Sharif-University-ESRLab/project-97110036-98105813/README.md

Project: Calculating the Power of SmartButton 

Project No. 2

Group No. 4

Members:
- Mohammad Ali Pashanj 97110036
- Mohammad Bagher Soltani 98105813

Summer 2022
