Sharif-University-ESRLab/project-97110036-98105813/Datasheet/Packaging/Soli's Box.JPG

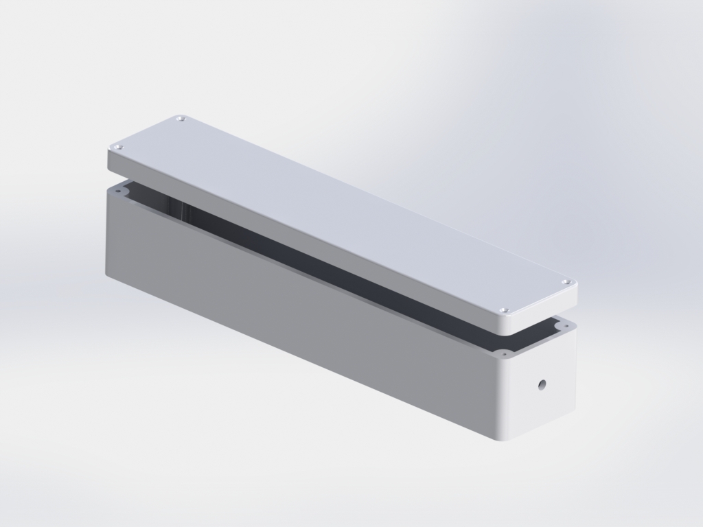
Datasheet/Packaging/Soli's Box.JPG
