Sharif-University-ESRLab/project-97110036-98105813/Datasheet/Packaging/Box and Lid.SLDASM

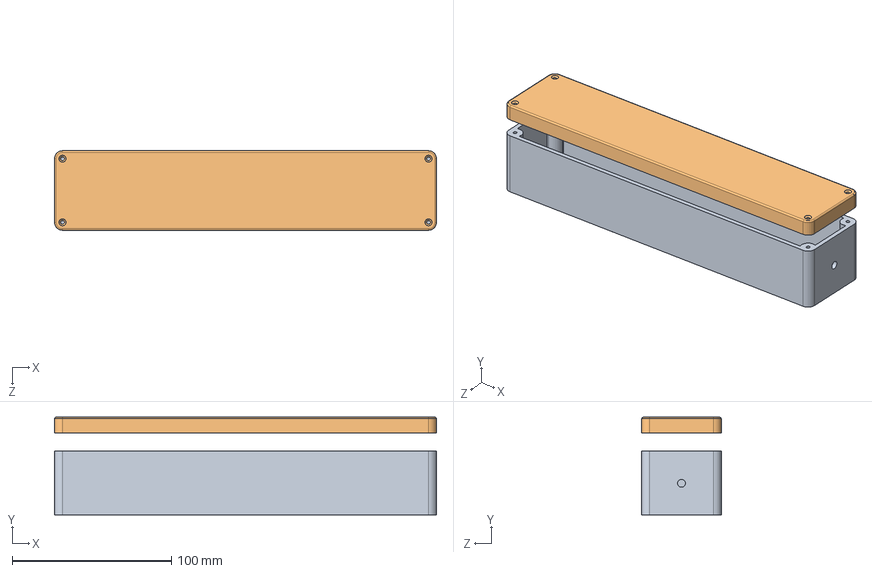
[picture p17: CAD file, 2022-09-03]
Datasheet/Packaging/Box and Lid.SLDASM
240.0 x 61.4 x 50.0 mm
lid
