Sharif-University-ESRLab/project-97110036-98105813/Datasheet/Packaging/lid.SLDPRT

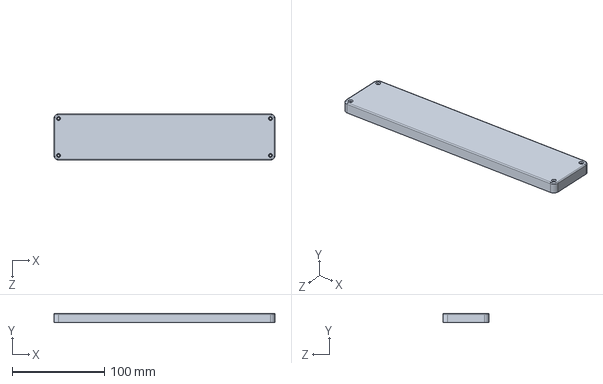
[picture p18: CAD file, 2022-09-03]
Datasheet/Packaging/lid.SLDPRT
240.0 x 10.0 x 50.0 mm
