Sharif-University-ESRLab/project-97110036-98105813/Datasheet/Packaging/box.SLDPRT

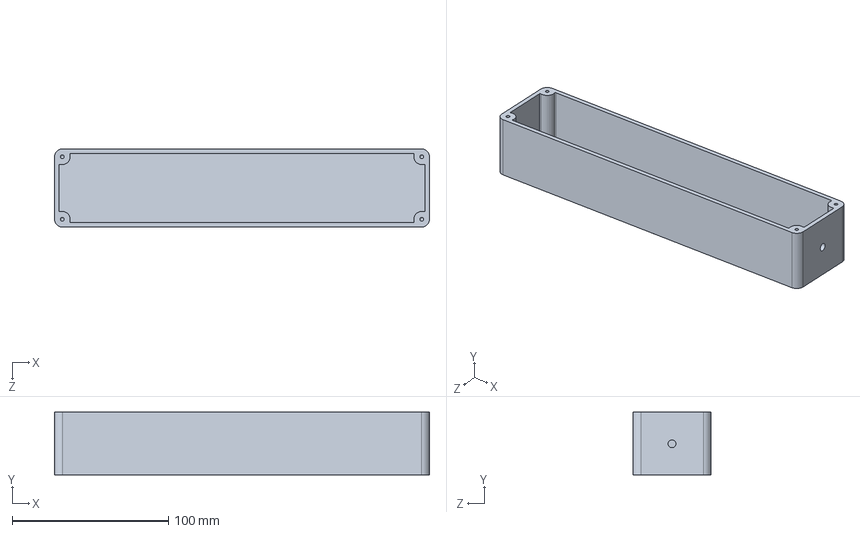
[picture p19: CAD file, 2022-09-03]
Datasheet/Packaging/box.SLDPRT
240.0 x 40.0 x 50.0 mm
