Sharif-University-ESRLab/project-97110036-98105813/Document/results/Average Downward Curve for Both Lamps without wifi.png

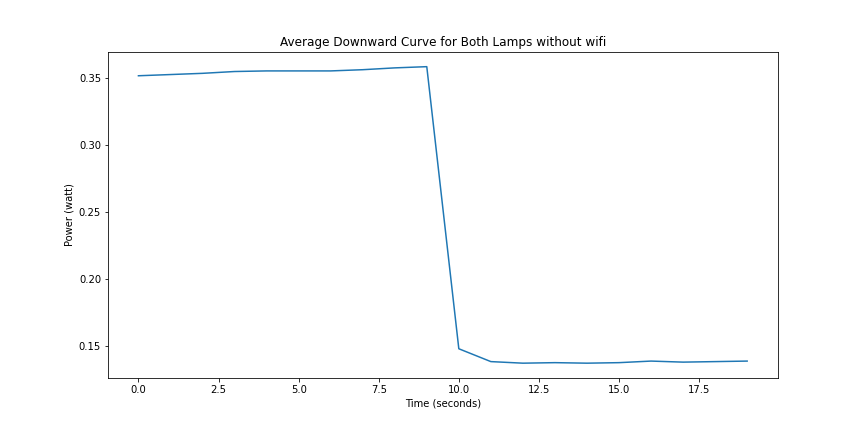
Document/results/Average Downward Curve for Both Lamps without wifi.png
