Sharif-University-ESRLab/project-97110036-98105813/Document/results/Average Downward Curve for Both Lamps.png

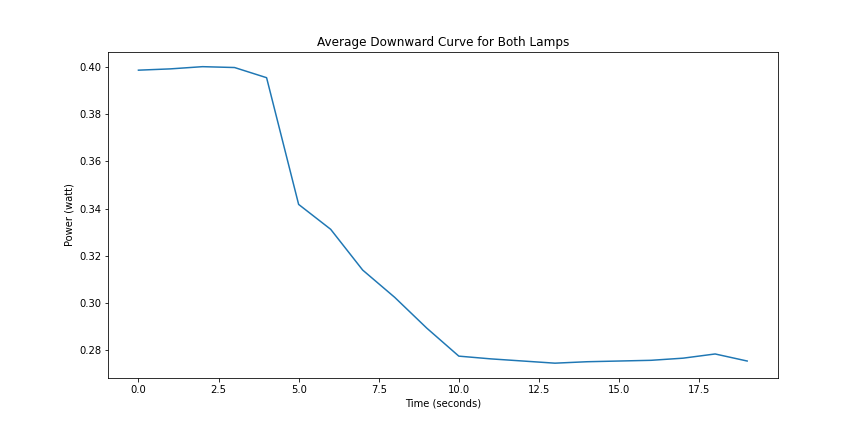
Document/results/Average Downward Curve for Both Lamps.png
