Sharif-University-ESRLab/project-97110036-98105813/Document/results/Average Downward Curve for Lamp 1.png

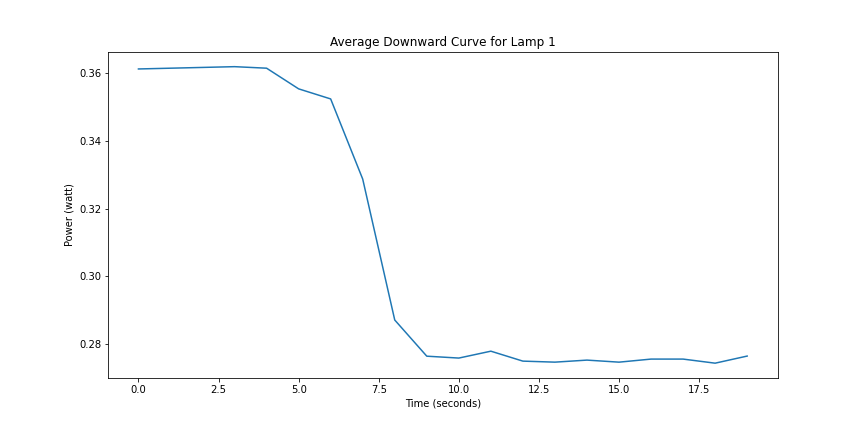
Document/results/Average Downward Curve for Lamp 1.png
