Sharif-University-ESRLab/project-97110036-98105813/Document/results/Average Upward Curve for Both Lamps without wifi.png

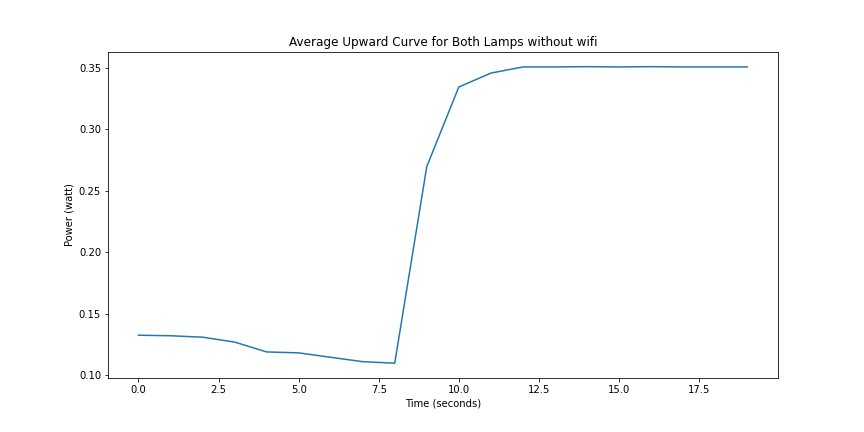
Document/results/Average Upward Curve for Both Lamps without wifi.png
