Sharif-University-ESRLab/project-97110036-98105813/Document/results/Downward Curves for Both Lamps without wifi.png

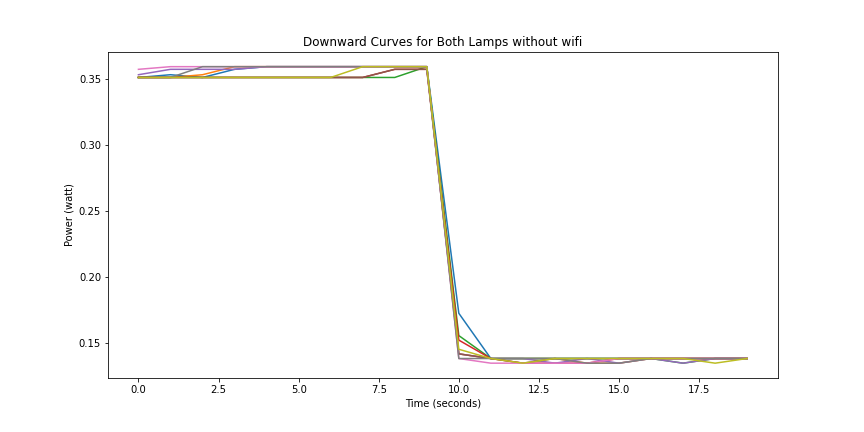
Document/results/Downward Curves for Both Lamps without wifi.png
