Sharif-University-ESRLab/project-97110036-98105813/Document/results/Downward Curves for Both Lamps.png

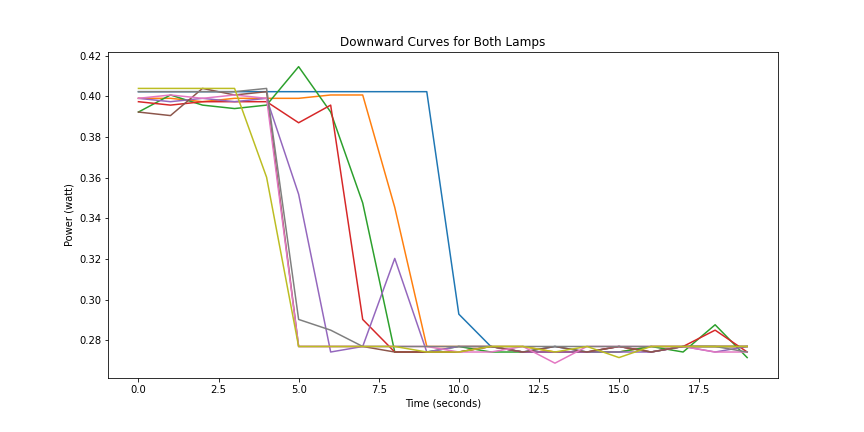
Document/results/Downward Curves for Both Lamps.png
