Sharif-University-ESRLab/project-97110036-98105813/Document/results/Downward Curves for Lamp 1.png

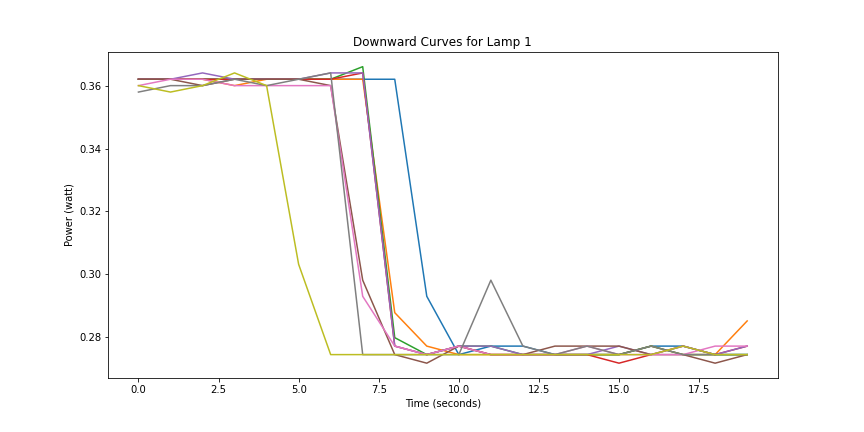
Document/results/Downward Curves for Lamp 1.png
