Sharif-University-ESRLab/project-97110036-98105813/Document/results/Downward Curves for Lamp 2.png

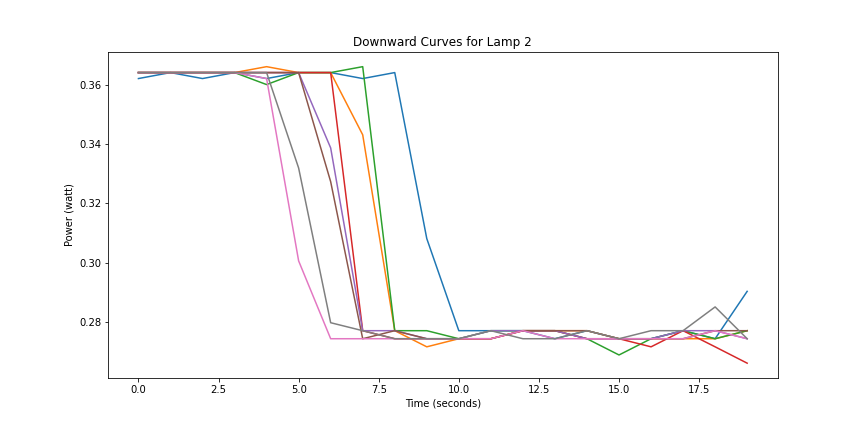
Document/results/Downward Curves for Lamp 2.png
