Sharif-University-ESRLab/project-97110036-98105813/Document/results/High Powers Distribution for Both Lamps without wifi.png

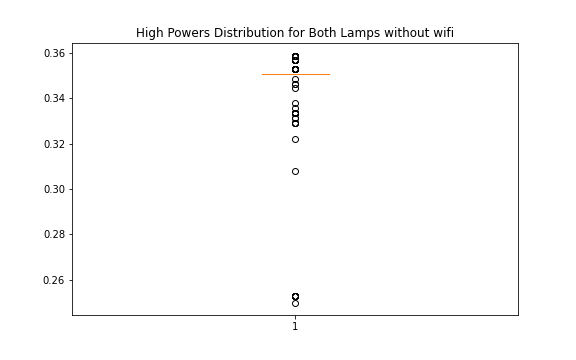
Document/results/High Powers Distribution for Both Lamps without wifi.png
