Sharif-University-ESRLab/project-97110036-98105813/Document/results/Low Powers Distribution for Lamp 1 without wifi.png

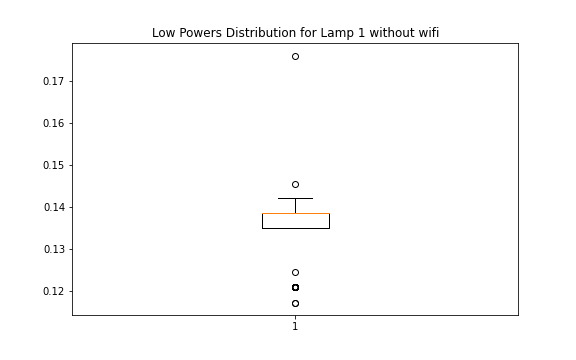
Document/results/Low Powers Distribution for Lamp 1 without wifi.png
