Sharif-University-ESRLab/project-97110036-98105813/Document/results/Power Values for Both Lamps without wifi.png

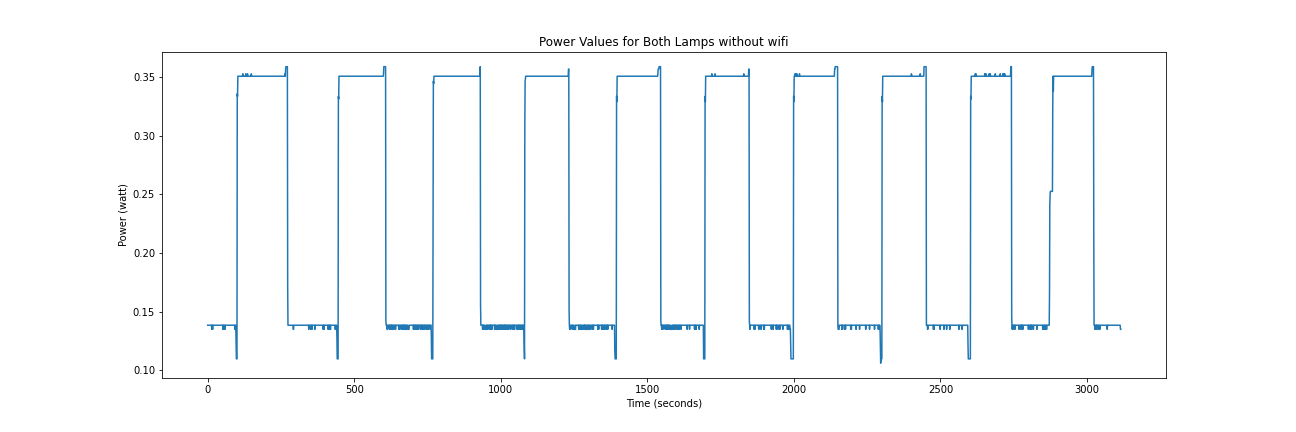
Document/results/Power Values for Both Lamps without wifi.png
