Sharif-University-ESRLab/project-97110036-98105813/Document/results/Power Values for Lamp 1.png

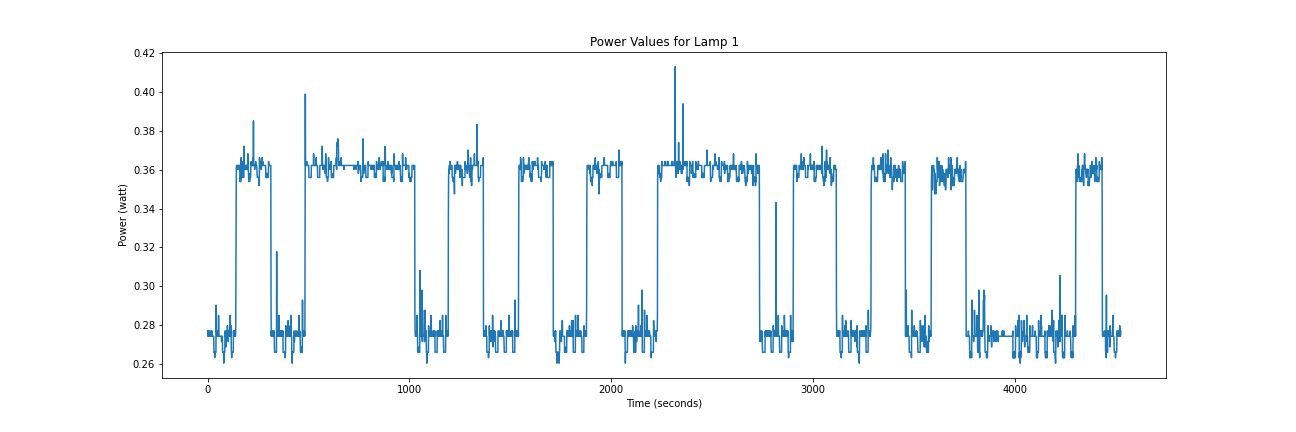
Document/results/Power Values for Lamp 1.png
