Sharif-University-ESRLab/project-97110036-98105813/Document/results/Power Values for Lamp 2 without wifi.png

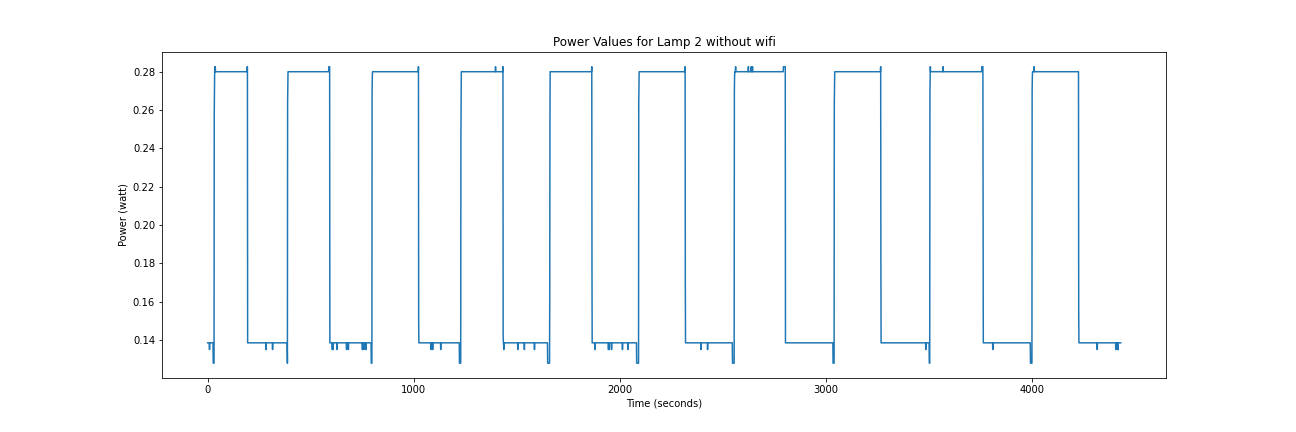
Document/results/Power Values for Lamp 2 without wifi.png
