Sharif-University-ESRLab/project-97110036-98105813/Document/results/Upward Curves for Lamp 1.png

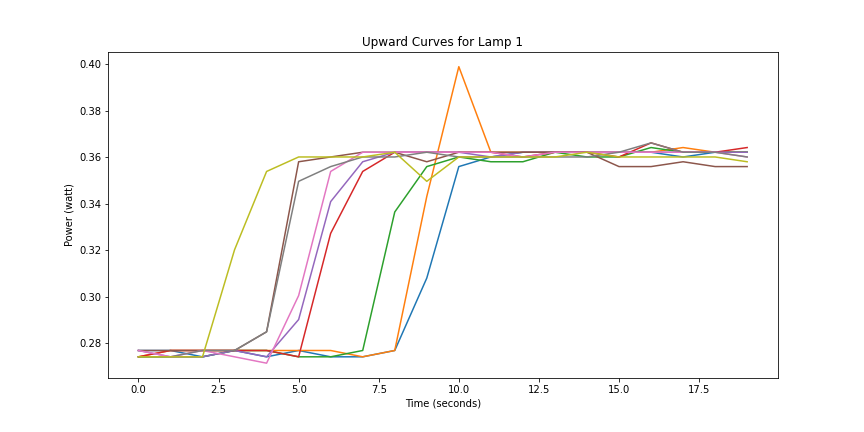
Document/results/Upward Curves for Lamp 1.png
