Sharif-University-ESRLab/project-97110036-98105813/Document/results/Upward Curves for Lamp 2.png

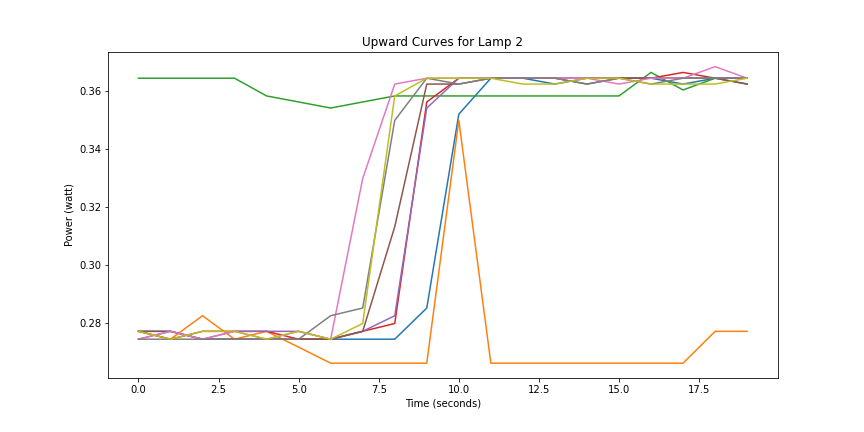
Document/results/Upward Curves for Lamp 2.png
