Sharif-University-ESRLab/project-97110036-98105813/(commit log)

2022-08-23 voltmeter code
2022-09-03 Added packaging files
    [Box and Lid.SLDASM, box.SLDPRT, lid.SLDPRT]
